lucianocampos/Isolated_Oscilloscope_Differential_Probe/03_Documentación/02_Diseño/IODP_DyD.pdf

## Punta Diferencial Aislada para Osciloscopio

### Especificaciones de diseño

Luciano J. Campos

Punta Diferencial Aislada para Osciloscopio | Rev. A – Mayo 2026

### Resumen

### Resumen

En el presente documento se desarrolla el diseño de una punta diferencial aislada para osciloscopio orientada a tareas de depuración, validación y análisis experimental de circuitos electrónicos. El objetivo del proyecto es obtener una herramienta de laboratorio que permita observar señales diferenciales, o señales referidas a potenciales no necesariamente comunes con la masa del osciloscopio, incorporando para ello una etapa de entrada diferencial, acondicionamiento analógico, aislación galvánica, fuente aislada y una salida compatible con una entrada BNC estándar.

El diseño propuesto no pretende reemplazar instrumental diferencial comercial de grado metrológico ni constituir un equipo certificado para mediciones de seguridad eléctrica. En su lugar, se busca una solución razonablemente robusta, calibrable y segura para uso personal controlado, priorizando la implementación física, la protección de entrada, la aislación, el layout y la posterior validación práctica por encima de la obtención de especificaciones metrológicas estrictas.

A lo largo del documento se presentan las especificaciones adoptadas, la arquitectura general del circuito y las decisiones de diseño asociadas a cada bloque funcional: front-end de entrada, red de atenuación, acoplamiento AC/DC, filtrado, etapas amplificadoras, paso aislado, salida y fuentes de alimentación. Para cada caso se justifican las elecciones realizadas en función de los compromisos entre ancho de banda, ruido, rechazo de modo común, seguridad, complejidad del circuito y factibilidad de implementación en PCB.

Finalmente, se reserva una sección para la medición y validación experimental del prototipo, donde se verificarán en una etapa posterior parámetros tales como ganancia, ancho de banda, respuesta en frecuencia, rechazo de modo común, nivel de ruido, comportamiento frente a señales de gran amplitud, desempeño de la aislación y estabilidad general del circuito. Por este motivo, las especificaciones indicadas en el presente informe deben interpretarse inicialmente como objetivos de diseño, quedando su cumplimiento definitivo sujeto a la caracterización experimental del prototipo.

### Parte I

# Especificaciones

### 1 Especificaciones : IMPORTANTE

Las especificaciones indicadas en la tabla siguiente corresponden a objetivos de diseño preliminares. Su cumplimiento efectivo deberá verificarse experimentalmente sobre el prototipo implementado, por lo que no deben interpretarse como valores garantizados antes de la etapa de caracterización.

El instrumento se encuentra orientado a tareas de depuración y validación experimental de circuitos electrónicos. No se considera apto para mediciones de seguridad eléctrica ni como reemplazo de una punta diferencial comercial certificada.

No se asigna una categoría de medición CAT al instrumento. La aislación especificada debe entenderse como un objetivo de diseño eléctrico y físico del prototipo, no como una certificación de seguridad.

La tensión máxima admisible de entrada deberá interpretarse en conjunto con el modo de operación seleccionado, la ganancia configurada, el estado de acoplamiento AC/DC y las limitaciones de potencia de los elementos de protección.

### 2 Especificaciones técnicas de diseño

Parámetro | Símbolo | Descripción
Tipo de entrada | – | Diferencial aislada
Aislación | VISO | ≥ 1,5 kVrms
Acoplamiento | – | AC, DC
Ganancia | G | 10x, 100x, 1000x
Error de ganancia | εG | ≤ 1 %
Ruido referido a la entrada | en,RTI | ≤ 10 µVRMS, BW = 100 kHz, G = 1000x
Rango de salida | VOUT | ±10 V
Impedancia de salida | ZOUT | 50 Ω
Corriente de salida máxima | IOUT,max | 150 mA
Rango de entrada diferencial | VIN,diff | Ganancia 10x: | ± 1 V
| | Ganancia 100x: | ±100 mV
Ganancia 1000x: ± 10 mV
Rango de entrada a modo común | VCM | Acoplamiento DC |VCM| ≤ 10 V
| | Acoplamiento AC | |VCM| ≤ 50 V
Máxima tensión de entrada | VIN,max | ±40 V
(no destructiva)
Control de offset de salida | VOFF | ±10 V referido a la salida
Ancho de banda superior | fH | 1 kHz, 10 kHz, 100 kHz
Ancho de banda inferior (AC) | fL | ≤ 0,1 Hz
Impedancia de entrada diferencial | ZIN,diff | 2,2 MΩ
Impedancia de entrada por rama | ZIN,branch | ≈ 1,1 MΩ
Rechazo de modo común | CMRR | Acoplamiento DC: ≥ 90 dB, DC a fH
Acoplamiento AC: ≥ 90 dB, fL ≤ f ≤ fH
Tensión de alimentación | VCC | 5 V ± 0,5 V

Tabla 2.1: Especificaciones

### Parte II

# Diseño

### 3 Arquitectura general

La arquitectura general adoptada para la punta diferencial aislada se muestra en la figura 1. El circuito puede dividirse en dos secciones principales: la sección de entrada, asociada al circuito bajo prueba, y la sección de salida, asociada al osciloscopio; ambas separadas mediante una barrera de aislación galvánica.

La señal diferencial aplicada a la entrada atraviesa, en primer lugar, una etapa de protección contra sobre-tensión y transitorios a modo diferencial.

A continuación se dispone una red de acoplamiento seleccionable AC/DC. En modo AC se introduce un filtro pasa-altos pasivo que permite eliminar la componente continua de entrada. La conmutación entre ambos modos se realiza de forma simétrica en ambas ramas de la entrada diferencial, para no degradar innecesariamente el rechazo de modo común del sistema.

Luego del acoplamiento se incluye un filtrado de alta frecuencia. Este bloque limita el ancho de banda efectivo antes de las etapas activas y reduce la energía de señales fuera de banda que podrían producir saturación, rectificación no deseada o recuperación lenta en los amplificadores posteriores. En este diseño el filtrado se trata como parte del front-end y no únicamente como un elemento de acondicionamiento de salida, debido a que las señales de modo común y diferencial de alta frecuencia pueden afectar de forma directa el desempeño práctico de la punta.

La primera etapa activa se implementa con ganancia fija. Esta etapa establece una parte importante del nivel de señal interno y permite adaptar la amplitud disponible al rango útil del paso aislado. Sobre este nodo se prevé además la posibilidad de inyectar una corrección de offset, ya sea como compensación fija o como ajuste controlado externamente.

Antes del bloque de aislación se incorpora un filtro pasa-bajos de segundo orden con frecuencia de corte seleccionable. Este filtro permite limitar el ancho de banda de la punta a valores compatibles con el uso previsto y con el desempeño esperable del paso aislado.

La ganancia final del sistema se ajusta mediante una segunda etapa amplificadora seleccionable. Esta etapa define las escalas de salida disponibles, por ejemplo 1×, 10× y 100×, y permite adecuar el nivel de señal entregado al osciloscopio. Luego de esta etapa la señal atraviesa la barrera de aislación y es reconstruida en el dominio de salida, donde se entrega mediante un conector BNC compatible con la entrada de alta impedancia de un osciloscopio convencional.

Finalmente, las fuentes de alimentación del sistema se consideran parte de la arquitectura general debido a que condicionan tanto el nivel de ruido como el desempeño de la aislación. La sección de entrada se alimenta mediante una fuente aislada y regulada localmente, mientras la etapa de salida está referida a la masa del osciloscopio para mantener la aislación galvánica entre el circuito bajo prueba y el instrumento.

Punta Diferencial Aislada para Osciloscopio | Rev. A – Mayo 2026 Protección de entrada Acoplamiento AC/DC Filtro de HF Filtro pasa⁻bajos

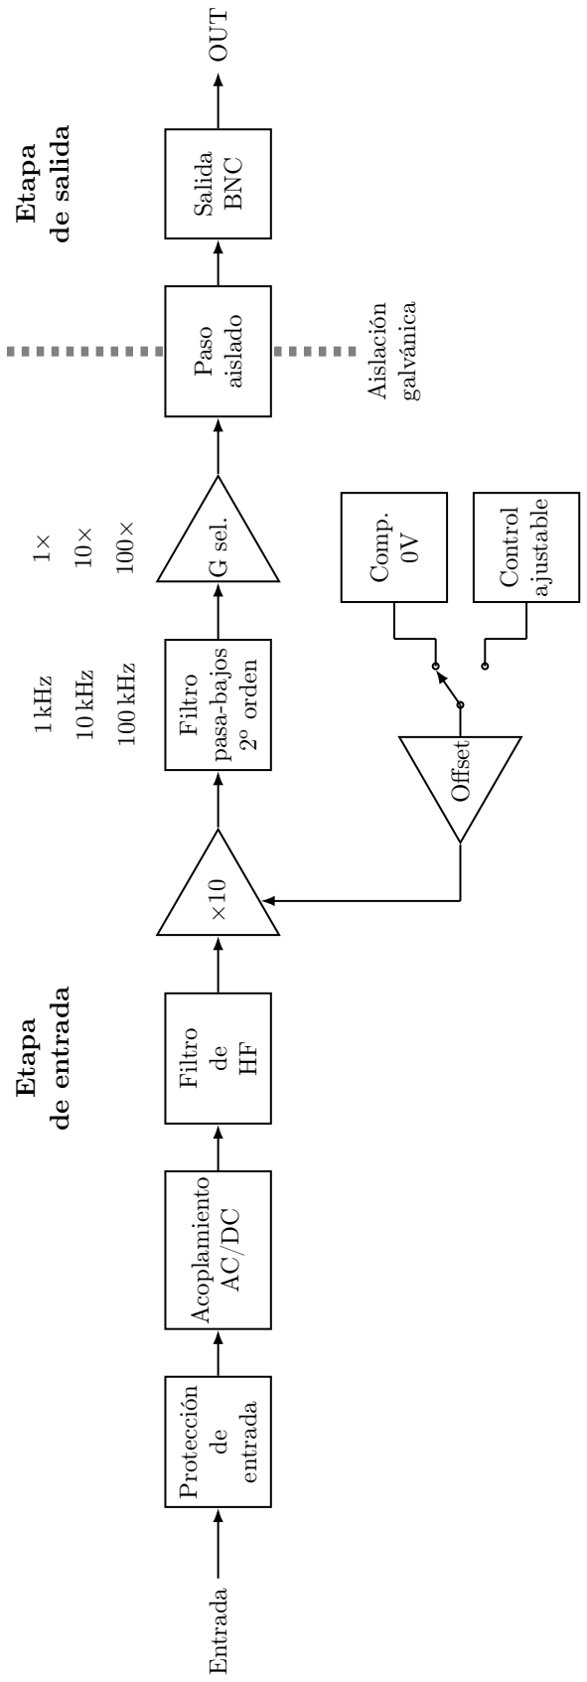
[picture p1: figure]
o orden; Paso; aislado; Salida; BNC; ×10 G sel. Entrada OUT; 1 kHz; 10 kHz; 100 kHz; 1× Etapa; de entrada; Etapa; de salida; Comp.; Control; ajustable; Offset; Aislación; galvánica

Figura 1: Arquitectura general propuesta para la punta diferencial aislada.

### 4 Front-end de entrada

El front-end de entrada constituye la primera interfaz entre el circuito bajo prueba y el resto de la punta diferencial; Concentra las funciones de protección, selección de acoplamiento, limitación de ancho de banda y primera amplificación diferencial.El desempeño global en robustez, ruido y rechazo de modo común quedan definidos en gran medida por esta sección.

En términos funcionales, el front-end puede dividirse en los bloques indicados en la figura 2: protección de entrada, acoplamiento AC/DC, filtrado de alta frecuencia y amplificador de instrumentación.

Figura 2: Bloques funcionales del front-end de entrada.

### 4.1. Topología del Front-End

El circuito conceptual por su parte se muestra en la figura ??

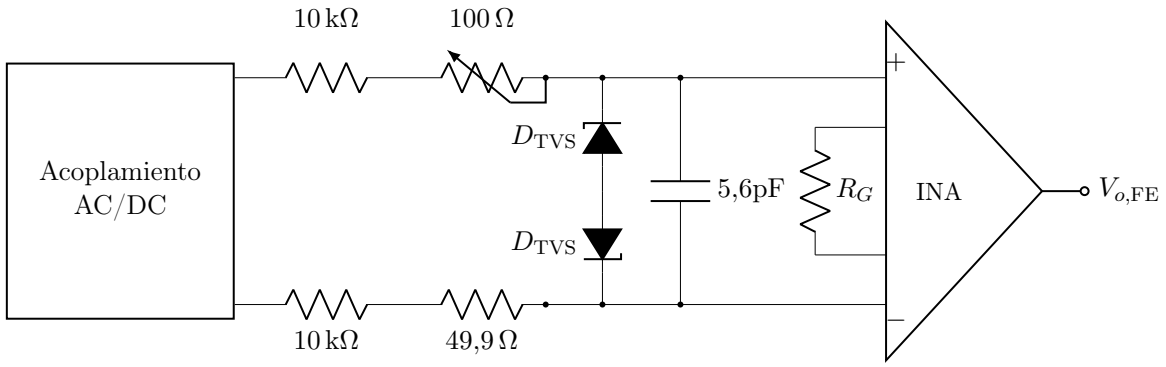
[picture p2: figure]
Acoplamiento AC/DC; DTVS; INA

Figura 3: Amplificador de entrada.

### 4.2. Protección de entrada

La red de protección de entrada limita la corriente máxima de las etapas posteriores ante sobreexcursiones de tensión, transitorios moderados o errores de conexión dentro de las condiciones previstas para el instrumento.

Desde el punto de vista de dimensionamiento, si se define una tensión máxima de falla VF y una tensión de clamp efectiva VCL, la resistencia mínima necesaria para limitar la corriente a un valor admisible ICL,max puede estimarse como

RP ≥

VF − VCL

ICL,max

(1)

donde RP representa el valor adoptado por rama, suponiendo una implementación simétrica. La potencia máxima disipada en la resistencia, en la condición de falla considerada, resulta

PRP ,max = I

2
CL,max RP | (2)

En esta etapa también resulta importante preservar la simetría entre ramas, dado que diferencias excesivas entre RP + y RP − degradan el rechazo de modo común del sistema. Si se define un desbalance ∆RP , la contribución resistiva al rechazo de modo común puede estimarse en primera aproximación mediante

CMRRR ≈ 20 log
2RP
∆RP
(3)

lo cual pone de manifiesto la conveniencia de emplear resistencias apareadas o de baja tolerancia en esta zona del circuito.

La red de protección implementada se muestra en la figura 4. El trimpot se emplea para compensar la diferencia de resistencia entre ambas ramas y balancear ambas ramas. Por su parte, el diodo TVS bidireccional limita la tensión diferencial aplicada al bloque siguiente. Este bloque únicamente protege los capacitores del filtro pasa-altos ante condiciones de sobretensión.

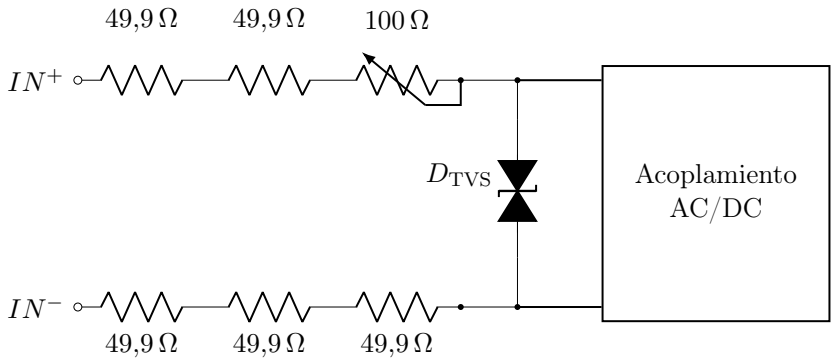
[picture p3: figure]
DTVS; Acoplamiento

Figura 4: Circuito implementado de protección de entrada.

Dimensionamiento de la protección de entrada La red de protección se implementa mediante una resistencia serie distribuida de aproximadamente 150 Ω por rama. Para ello se emplean tres resistores de 49,9 Ω en serie en cada una de las ramas de entrada, de forma que

RP + = RP − = 3 · 49,9 Ω = 149,7 Ω | (4)

La resistencia diferencial total vista por el TVS durante un evento de sobretensión diferencial resulta entonces

RΣ = RP + + RP − = 2 · 149,7 Ω = 299,4 Ω | (5)

El TVS seleccionado posee una tensión inversa de trabajo de 43 V, y una tensión máxima de clampeo se considera igual a 49 V; por este motivo, los capacitores de acoplamiento de la etapa siguiente se seleccionan con tensión nominal mínima de 63 V, dejando margen respecto de la máxima tensión diferencial esperada durante la acción de protección.

Para una tensión diferencial de entrada VIN,d superior a la tensión de clampeo, la corriente aproximada por el TVS queda dada por

ITVS ≈

|VIN,d| − VCL
RΣ

(6)

Considerando VCL = 49 V y una tensión diferencial de entrada de 60 V, se obtiene

ITVS ≈

60 V − 49 V
299,4 Ω | = 36,7 mA | (7)

La potencia total disipada en las resistencias serie resulta entonces

PR,tot = I

2

TVSRΣ = (36,7 mA)²
- 299,4 Ω ≈ 0,40W | (8)

Dado que ambas ramas presentan la misma resistencia serie, la potencia disipada por rama queda dada por

PR,rama = I

2

TVSRP = (36,7 mA)²
- 149,7 Ω ≈ 0,20W | (9)

Como cada rama se implementa mediante tres resistores de igual valor, la potencia disipada por cada resistor resulta

PRx = I

2

TVS · 49,9 Ω = (36,7 mA)²
- 49,9 Ω ≈ 67 mW | (10)

Esta distribución reduce la potencia disipada por componente sin modificar de forma significativa la resistencia diferencial total de la red de protección. No obstante, estos valores deben interpretarse como solicitaciones asociadas a eventos de protección y no necesariamente como una condición de operación continua. En consecuencia, la potencia admisible de los resistores, la energía soportada por el TVS y la duración esperada del evento deberán verificarse en conjunto.

### 4.3. Acoplamiento AC/DC

El bloque de acoplamiento permite seleccionar entre medición en continua y medición en alterna. En modo DC, las llaves SDC+ y SDC− puentean los capacitores de acoplamiento, con lo cual la transferencia en baja frecuencia se extiende hasta continua.

La figura 5 muestra la implementación adoptada para el bloque de acoplamiento AC/DC. En modo DC, las llaves SDC+ y SDC− puentean los capacitores de acoplamiento, con lo cual la transferencia en baja frecuencia se extiende hasta continua. En modo AC, los capacitores quedan insertados en serie y la red formada por RP , RT P y RP establece el camino de polarización de ambas ramas hacia la referencia de señal.

Considerando el requerimiento de impedancia de entrada mínima, Zin > 1 MΩ, y el mínimo CMRR necesario para asegurar un error total menor a eT ≤ 1 %, los capacitores de acoplamiento se escogen de

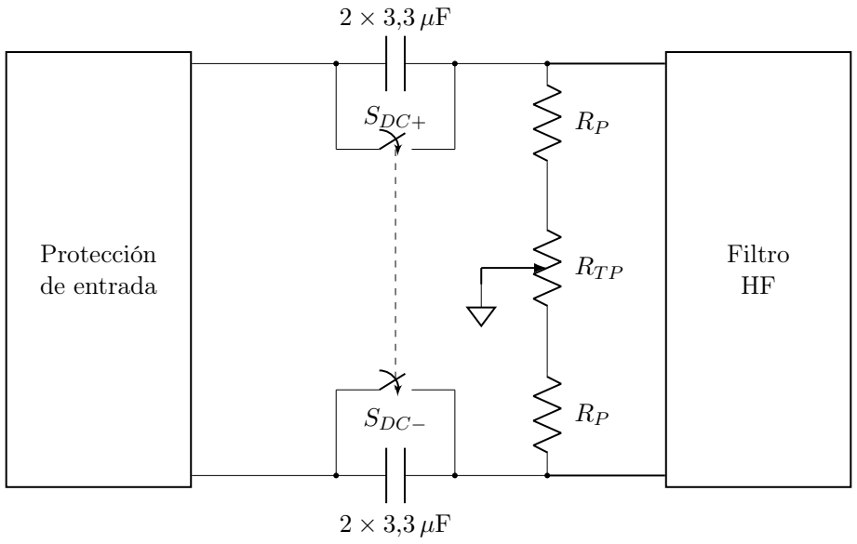
[picture p4: figure]
Protección de entrada; SDC+; SDC−; Filtro HF

Figura 5: Bloque de acoplamiento AC/DC implementado.

manera tal que la frecuencia de corte sea muy inferior al límite inferior del ancho de banda esperado. Por lo tanto, considerando RP ≈ 1 MΩ:

fc =

1
2πRP C

≪ 0,1 Hz =⇒ C ≫

1
2π · 1 MΩ · 0,1 Hz
= 1,59 µF | (11)

Se adopta entonces, por rama,

C0 = 2 · 4,7 µF = 8,8 µF | (12)

Considerando una tolerancia del 5 %, el rango de capacidad posible por rama queda comprendido entre
C+
C−

m´ax

=

1,05 C0
0,95 C0
= 1,105 | (13)

El trimpot del circuito de la figura 5 permite calibrar la constante de tiempo de cada rama para preservar la simetría del front-end en modo AC. Definiendo a como la posición normalizada del cursor del trimpot, las resistencias efectivas de cada rama pueden escribirse como

R+ = RP + aRT P | ; | R− = RP + (1 − a)RT P , 0 ≤ a ≤ 1 | (14)

La condición de balance de constantes de tiempo queda dada por

R+C+ = R−C− | (15)
(RP + aRT P ) C+ = (RP + (1 − a)RT P ) C− | (16)

Considerando la tolerancia de los capacitores de acoplamiento, la relación máxima de resistencias que debe poder compensar el ajuste resulta

R+
R−

=

Cm´ax

Cm´ın

= 1,105 | (17)

Para verificar el rango de ajuste disponible se adopta

RP = 1 MΩ | ; | RT P = 200 kΩ | (18)

En condición nominal, la máxima relación de resistencias obtenible entre ramas resulta
R+
R−

m´ax

=

RP + RT P

| RP | = 1,2 MΩ
| | 1 MΩ = 1,20 | (19)

Sin embargo, debe considerarse también la tolerancia del propio trimpot. Para una tolerancia del 10 %,

RT P,m´ın = 0,9 · 200 kΩ = 180 kΩ | (20)

y por lo tanto el peor caso de rango disponible queda dado por
R+
R−

m´ax,m´ın

=

RP + RT P,m´ın
RP

=

1,18 MΩ
1 MΩ = 1,18 | (21)

De esta forma el trimpot de 200 kΩ resulta suficiente aun considerando su tolerancia negativa máxima. Esto se verifica calculando la posición de ajuste necesaria en el peor caso. Si una rama presenta Cm´ın y la otra Cm´ax, debe cumplirse

R+
R−
= 1,105 | (22)

es decir,

RP + aRT P
RP + (1 − a)RT P
= 1,105 | (23)

Despejando a,

a =

k(RP + RT P ) − RP
RT P (1 + k)

con k =

Cm´ax

Cm´ın

= 1,105 | (24)

Reemplazando RP = 1 MΩ y RT P = 200 kΩ,

a =

1,105 · 1,2 MΩ − 1 MΩ
200 kΩ · (1 + 1,105) = 0,775 | (25)

Por lo tanto, aun en el peor caso de dispersión de los capacitores, el ajuste requerido queda dentro del recorrido útil del trimpot. En la condición inversa se obtiene la posición complementaria, 1 − a = 0,225, por lo que el margen de ajuste es simétrico respecto de cuál de las dos ramas presente la mayor capacidad.

### 4.4. Amplificador de entrada

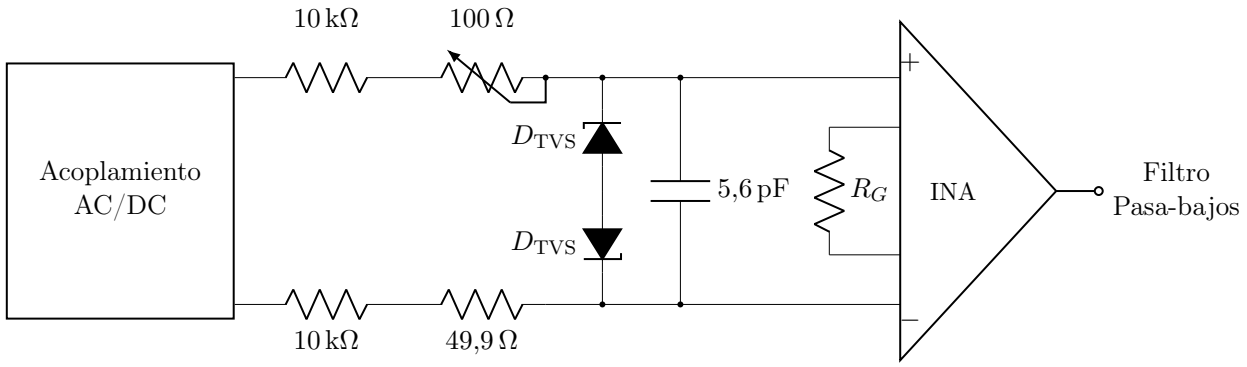
[picture p5: figure]
Acoplamiento AC/DC; DTVS; INA; Filtro Pasa-bajos

Figura 6: Amplificador de entrada.

Protección diferencial secundaria Además de la protección diferencial ubicada en la entrada del instrumento, se incorpora una segunda protección antes del amplificador de instrumentación. Esta etapa se implementa mediante un diodo TVS bidireccional conectado entre las ramas diferenciales, luego de las resistencias serie RS (figura 6). De esta manera, la tensión diferencial aplicada al amplificador queda limitada a un valor inferior a la tensión de alimentación disponible.

VIN,m´ax ≤ 8,5 V < VCC = 12 V | (26)

En esta posición del circuito no se agrega un filtro HF discreto adicional. La capacidad parásita del TVS, en conjunto con las resistencias serie RS, introduce una limitación de ancho de banda local antes de la entrada del amplificador de instrumentación.

La corriente máxima en condición de falla queda limitada por la protección diferencial previa y por las resistencias serie de esta segunda etapa. Considerando una tensión máxima de clampeo de la protección anterior de 60 V, una tensión diferencial máxima en el TVS secundario de 8,5 V y dos resistencias serie de 10 kΩ, se obtiene

IF,m´ax ≤

Vclamp,in − VIN,m´ax
2RS

=

60 V − 8,5 V
2 · 10 kΩ | = 2,58 mA | (27)

Por lo tanto, la potencia total disipada por cada resistor de 10 kΩ queda dada por

PR = I

2

F,m´ax · RS = (2,58 mA)²
- 10 kΩ ≈ 66 mW | (28)

El diodo TVS escogido es el PJGBLC05 de Panjit International Inc. Para el dimensionamiento se considera una tensión máxima de activación de 7,0 V, de manera de verificar que la tensión diferencial aplicada al amplificador permanezca por debajo de la alimentación disponible. Su capacidad de juntura parásita, del orden de 3 pF, actúa además como capacitancia diferencial de alta frecuencia. En conjunto con las resistencias serie RS y el capacitor de filtro CF , dicha capacitancia introduce un polo pasa-bajos aproximado dado por

fp,TVS ≈

1
2π (2RS) CTVS

(29)

Reemplazando RS = 10 kΩ y CTVS = 6 pF:

fp,TVS ≈

1
2π · 20 kΩ · [(3 pF||3 pF) + 5,6pF]
≈ 1,07 MHz | (30)

Ganancia del amplificador de instrumentación El amplificador de instrumentación seleccionado es el INA826AIDR. Se adopta una ganancia fija G = 10 porque mantiene un ancho de banda elevado para el uso previsto (500 kHz), y un buen rechazo de modo común (104 dB en DC hasta 60 Hz, y 100 dB a 5 kHz).

La ganancia del INA826 se fija mediante una única resistencia externa RG entre los pines de ganancia, según

G = 1 +

49,4 kΩ
RG

=⇒ RG =

49,4 kΩ
G − 1

=

49,4 kΩ
9
= 5,489 kΩ | (31)

Se adopta RG = 5,49 kΩ, 0,1 %.

### 5 Filtro pasabajos seleccionable

La salida del amplificador de entrada se aplica a un filtro pasabajos pasivo de segundo orden, mostrado en la figura 7. La topología adoptada corresponde a una red en escalera RC, formada por una resistencia serie equivalente de entrada

R1 = RP B1 + RP B2 = 866 Ω + 49,9 Ω = 915,9 Ω | (32)

seguida por una segunda resistencia serie

R2 = RP B3 = 10 kΩ | (33)

y dos capacitores shunt a masa aislada, seleccionados en forma simultánea mediante una llave de dos polos y tres posiciones. De esta forma, la frecuencia de corte puede conmutarse entre tres valores nominales, manteniendo la misma estructura del filtro.

Considerando que la impedancia de fuente vista por el filtro es baja y que de manera similar la impedancia de salida alta, la función de transferencia del filtro puede aproximarse por

H(s) = Vo(s)
Vi(s)

=

1
1 + s (R1C1 + (R1 + R2)C2) + s

2R1R2C1C2

(34)

La llave conmuta en forma conjunta las parejas (CF1, CF4), (CF2, CF5) y (CF3, CF6), es decir:

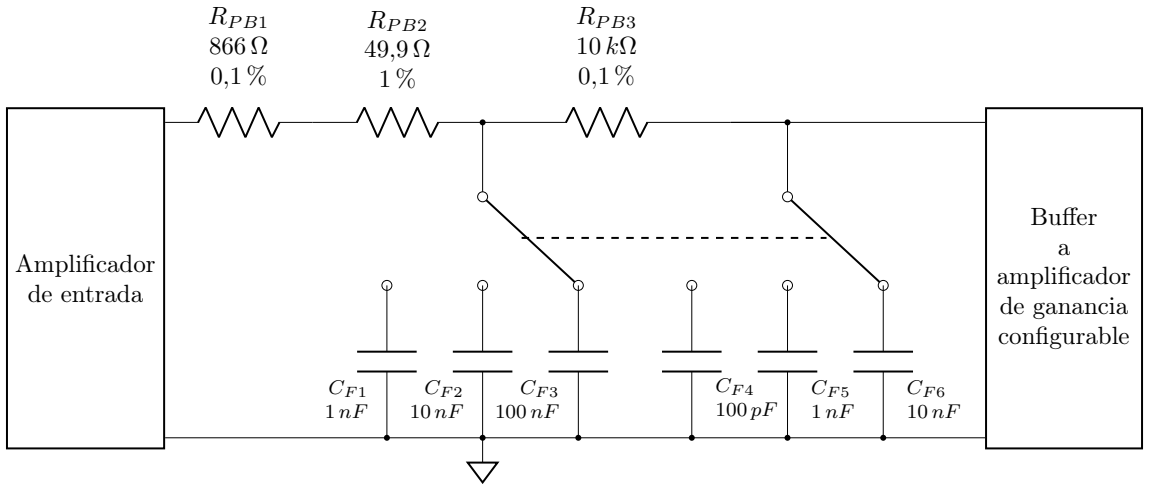
[picture p6: figure]
Amplificador de entrada; Buffer a amplificador de ganancia configurable

Figura 7: Filtro pasabajos con selección de ancho de banda.

(C1, C2) ∈ {(1 nF, 100 pF), (10 nF, 1 nF), (100 nF, 10 nF)} | (35)

Evaluando la expresión anterior con R1 = 915,9 Ω y R2 = 10 kΩ, se obtienen las frecuencias de corte resumidas en la tabla 5.1.

Posición | Capacitores seleccionados | fc calculada | fc nominal
1 | CF1 = 1 nF, CF4 = 100 pF | 100,06 kHz | 100 kHz
2 | CF2 = 10 nF, CF5 = 1 nF | 10,006 kHz | 10 kHz
3 | CF3 = 100 nF, CF6 = 10 nF | 1,001 kHz | 1 kHz

Tabla 5.1: Frecuencias de corte del filtro pasabajos para cada posición de la llave.

La elección de los capacitores mantiene una relación de escala de una década entre posiciones, por lo que el filtro reproduce de manera muy próxima las tres frecuencias de corte objetivo: 1 kHz, 10 kHz y 100 kHz.

### 6 Amplificador de ganancia configurable

El bloque de ganancia configurable se implementa mediante dos etapas no inversoras basadas en el ADA4610-1ARZ-R7. Cada etapa posee una ganancia

Av = 1 +

RF
RG

= 1 +

10 kΩ
15 kΩ ∥ 1,2 kΩ
≈ 10 | (36)

dado que

RG = 15 kΩ ∥ 1,2 kΩ = 15 kΩ · 1,2 kΩ 15 kΩ + 1,2 kΩ

= 1,111 kΩ | (37)

La ganancia total se conmuta por décadas mediante la llave doble del circuito, que habilita o desconecta atenuadores pasivos en los nodos de entrada de las etapas activas.

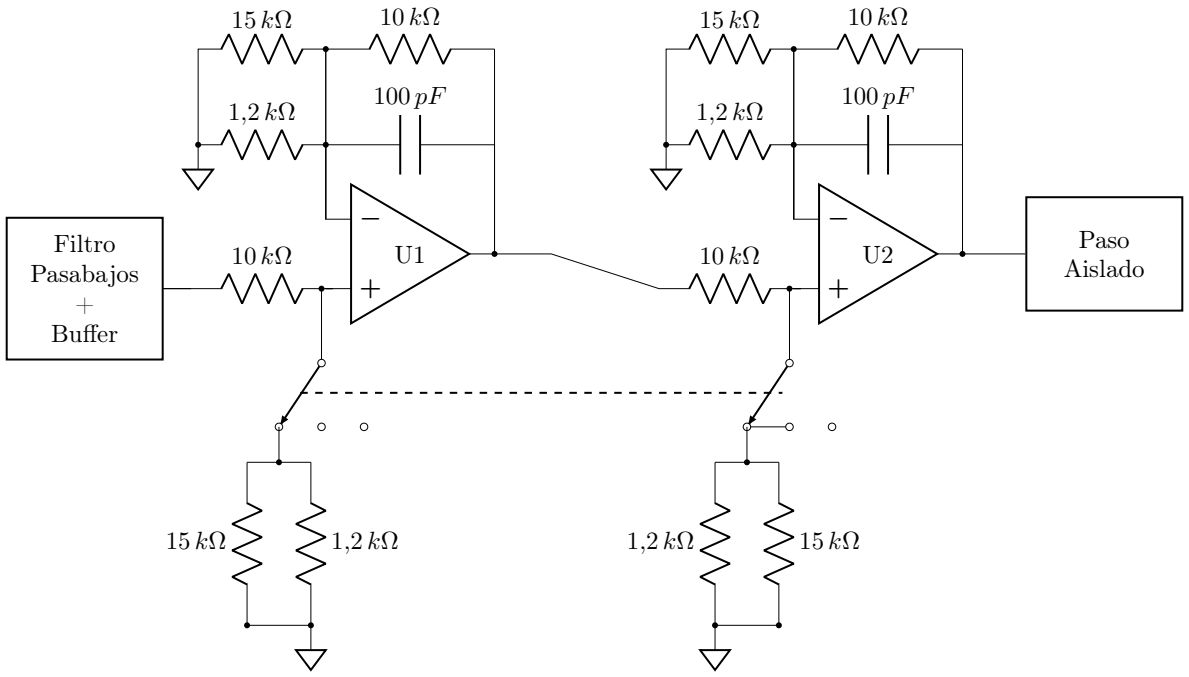
[picture p7: figure]
U2 Filtro; Pasabajos + Buffer; Paso Aislado

Figura 8: Amplificador de ganancia configurable.

Los atenuadores están definidos por las resistencias serie de 10 kΩ entre etapas y la resistencia equivalente a masa vista desde la entrada de cada operacional, por lo tanto

Aatt2 =

Ratt2
10 kΩ + Ratt2

=

15 kΩ ∥ 1,2 kΩ
10 kΩ + (15 kΩ ∥ 1,2 kΩ) ≈ 0,10 | (38)

Por otra parte, los operacionales están limitados en ancho de banda a

BW =

1
2π · Rf · Cf

=

1
2π · 10 kΩ · 100 pF
= 159,15 kHz | (39)

Considerando además la ganancia fija 10× del amplificador de instrumentación de entrada, las ganancias nominales del sistema para cada posición de la llave son:

Posición | Estado de atenuadores | Ganancia del bloque | Ganancia total
1 | Aatt1 y Aatt2 habilitados | 0,099 · 10 · 0,10 · 10 ≈ 0,99 | ≈ 10×
2 | Primer atenuador deshabilitado | 10 · 0,10 · 10 ≈ 10,0 | ≈ 100×
3 | Ambos atenuadores deshabilitados | 10 · 10 = 100 | ≈ 1000×

Tabla 6.1: Ganancia aproximada del bloque configurable para cada posición de la llave.

En términos funcionales, la llave selecciona tres rangos de ganancia separados aproximadamente por décadas. La posición 1 compensa la ganancia de ambas etapas activas mediante dos atenuadores cercanos a 10×, la posición 2 elimina el primer atenuador y deja activa una etapa adicional de 10×, y la posición 3 desconecta los dos atenuadores, utilizando la ganancia completa de las dos etapas no inversoras.

### 7 Paso aislado

### 8 Etapa de salida

### 9 Fuentes de alimentación

### 10 Consideraciones de seguridad y aislación

### Parte III

# Mediciones y validación experimental
