lucianocampos/Isolated_Oscilloscope_Differential_Probe/03_Documentación/02_Diseño/IODP_Especificaciones de diseño.pdf

## Punta Diferencial Aislada para Osciloscopio

## Especificaciones de dise˜no

Luciano J. Campos

Punta Diferencial Aislada para Osciloscopio | Rev. A – Mayo 2026

## 1 Especificaciones t´ecnicas de dise˜no

Par´ametro | S´ımbolo | Descripci´on
Tipo de entrada | – | Diferencial aislada
Aislaci´on | VISO | ≥ 1.5 kVrms
Acoplamiento | – | AC, DC
Ganancia | G | 10x, 100x, 1000x
Error de ganancia | εG | ≤ 1 %
Ruido referido a la entrada | en,RTI | ≤ 10 µVRMS, BW = 100 kHz, G = 1000x
Rango de salida | VOUT | ±10 V
Impedancia de salida | ZOUT | 50 Ω
Corriente de salida m´axima | IOUT,max | 150 mA
Rango de entrada diferencial | VIN,diff | Ganancia 10x: | ± 1 V
| | Ganancia 100x: | ±100 mV
| | Ganancia 1000x: | ± 10 mV
Rango de entrada a modo com´un | VCM | Acoplamiento DC | |VCM| ≤ 10 V
| | Acoplamiento AC | |VCM| ≤ 50 V
M´axima tensi´on de entrada | VIN,max | ±40 V
(no destructiva)
Control de offset de salida | VOFF | ±10 V referido a la salida
Ancho de banda superior | fH | 1 kHz, 10 kHz, 100 kHz
Ancho de banda inferior (AC) | fL | ≤ 0.1 Hz
Impedancia de entrada diferencial | ZIN,diff | 2.2 MΩ
Impedancia de entrada por rama | ZIN,branch | ≈ 1.1 MΩ
Rechazo de modo com´un | CMRR | Acoplamiento DC: ≥ 90 dB, DC a fH
Acoplamiento AC: ≥ 90 dB, fL ≤ f ≤ fH
Tensi´on de alimentaci´on | VCC | 5 V ± 0.5 V

Tabla 1.1: Especificaciones

1/ 1
