lucianocampos/Isolated_Oscilloscope_Differential_Probe/(list of files, drawings)

Other design files:
02_Hardware/01_Diseño/Isolated_Oscilloscope_Diferential_Probe.PrjPcb
02_Hardware/01_Diseño/Isolated_Oscilloscope_Diferential_Probe.SchDoc
