lucianocampos/Isolated_Oscilloscope_Differential_Probe/(commit log)

2026-05-01 Agrego especificaciones de diseño
2026-05-01 Mover archivos de diseño a documentación
    Los archivos habían sido subidos al directorio equivocado
2026-05-08 Documentación de diseño
2026-05-10 Actualizo etapa de entrada
2026-05-10 Diseño inicial
    [Isolated_Oscilloscope_Diferential_Probe.PrjPcb, Isolated_Oscilloscope_Diferential_Probe.SchDoc]
2026-05-10 Se modifica asociación entre partes, valores de resistores en paso aislado y se define emplazamiento de componentes inicial en pcb
    [Isolated_Oscilloscope_Diferential_Probe.PrjPcb, Isolated_Oscilloscope_Diferential_Probe.SchDoc]
2026-05-16 Modifico capacitores de reserva y entrada de alimentación
    [Isolated_Oscilloscope_Diferential_Probe.SchDoc]
2026-05-16 Avance de posicionamiento de componentes
